mareknespechal/Zasuvka/deska a vicko.jpg

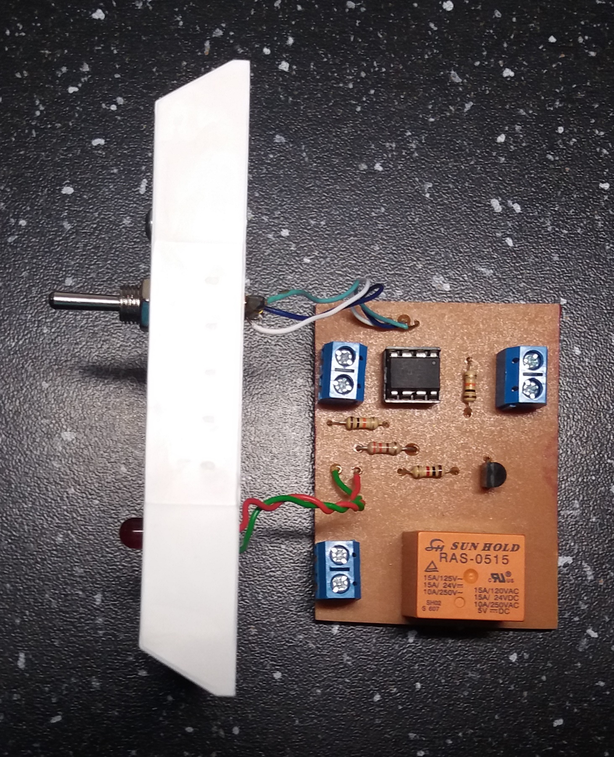
deska a vicko.jpg
