mareknespechal/Zasuvka/hotovo.jpg

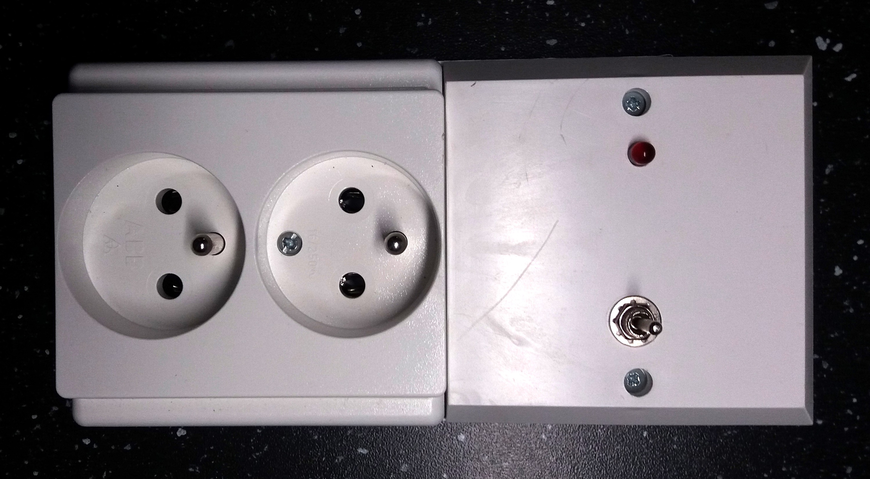
hotovo.jpg
