mareknespechal/Zasuvka/DPS.pdf

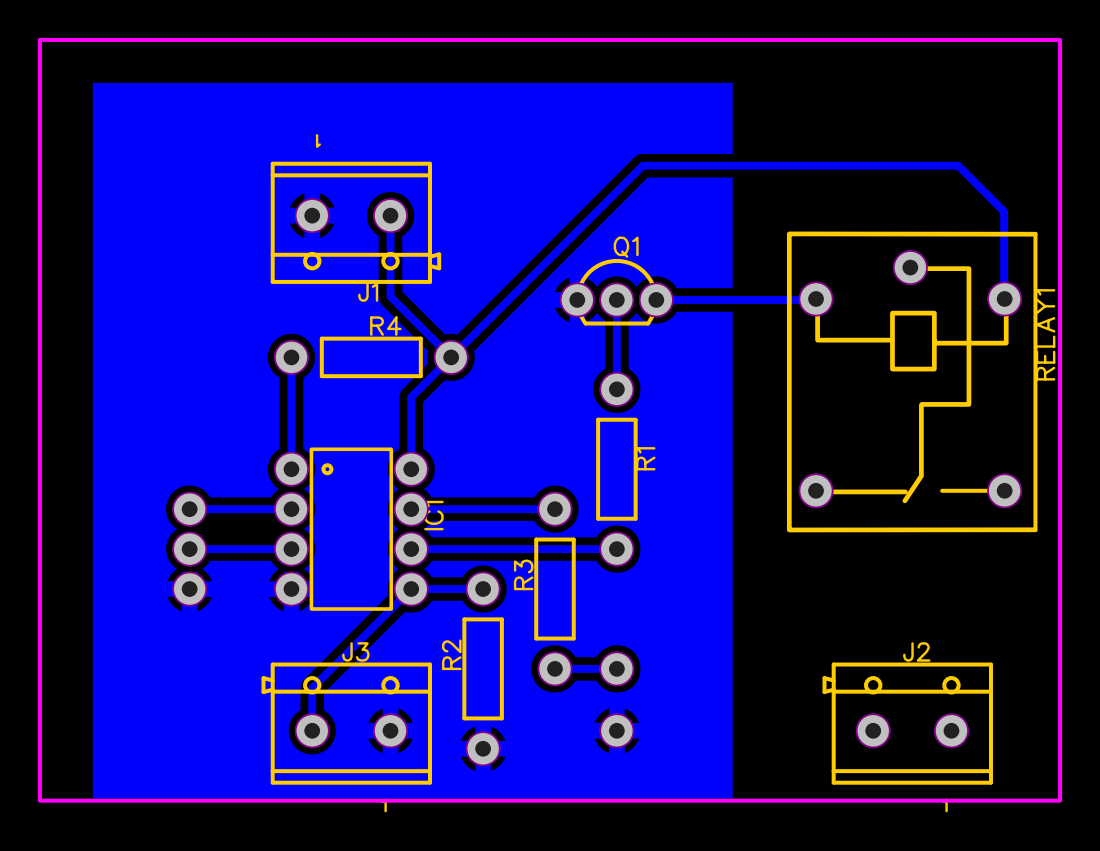
[picture p11: page 1]
