mareknespechal/Zasuvka/schema.pdf

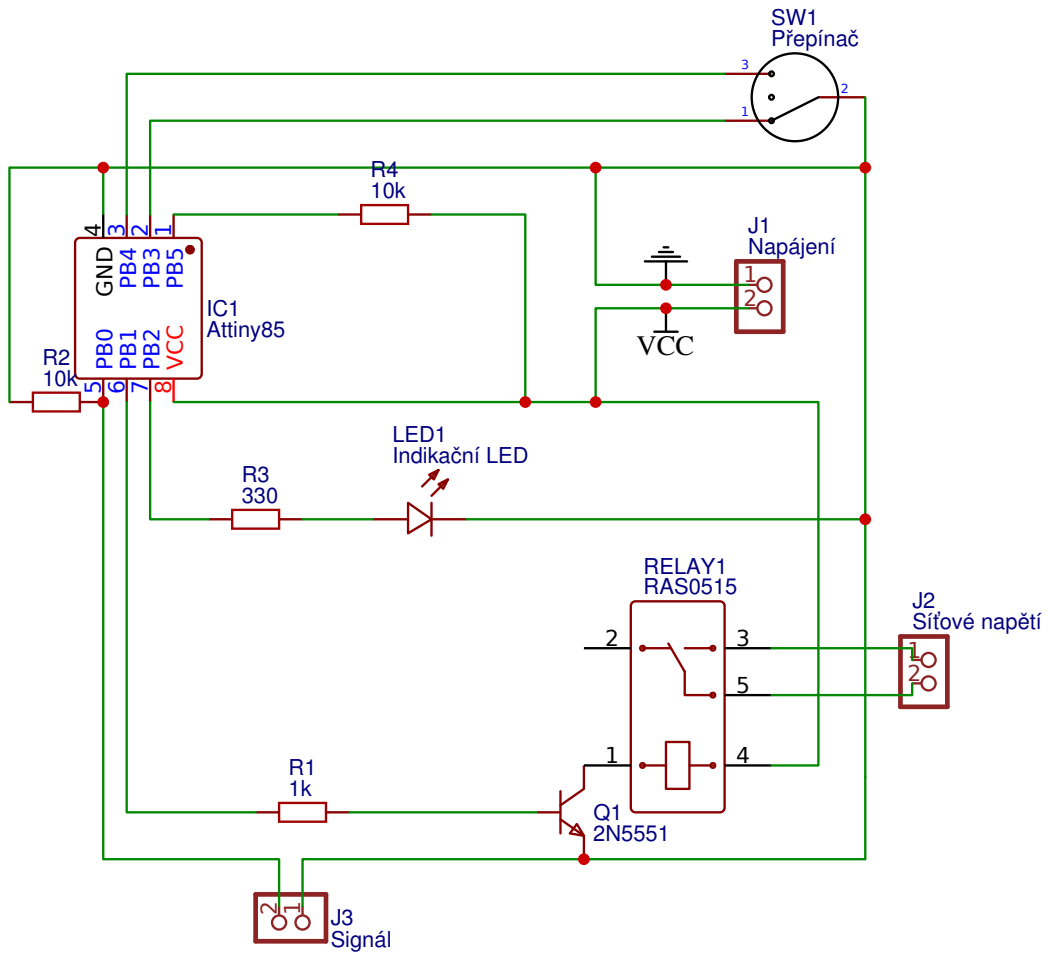
[picture p12: page 1]
